M4K1S/coldtrace/hardware/case/coldtrace_case.step

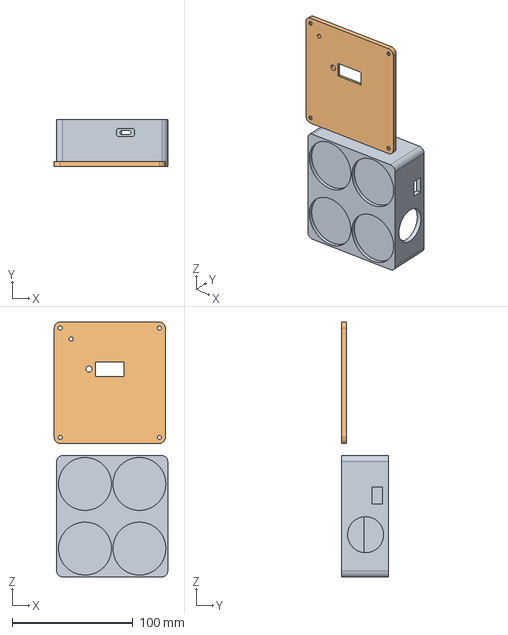
[picture p2: CAD file, 2026-10-11]
hardware/case/coldtrace_case.step
94.0 x 39.0 x 211.0 mm
