M4K1S/coldtrace/hardware/case/stl/case_lid.stl

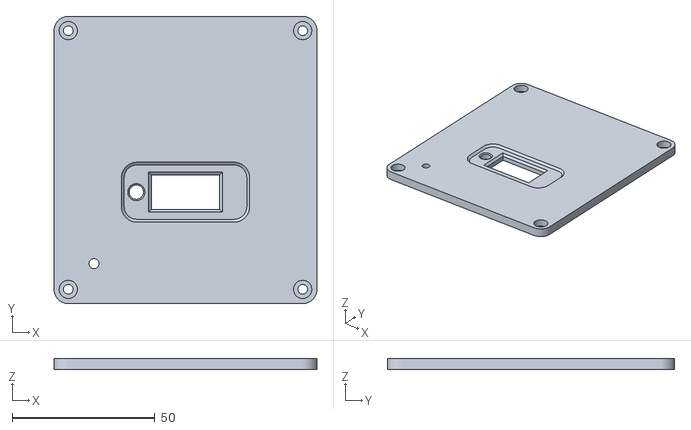
[picture p3: CAD file, 2026-10-11]
hardware/case/stl/case_lid.stl
92.0 x 100.5 x 4.00
