M4K1S/coldtrace/hardware/case/stl/case_base.stl

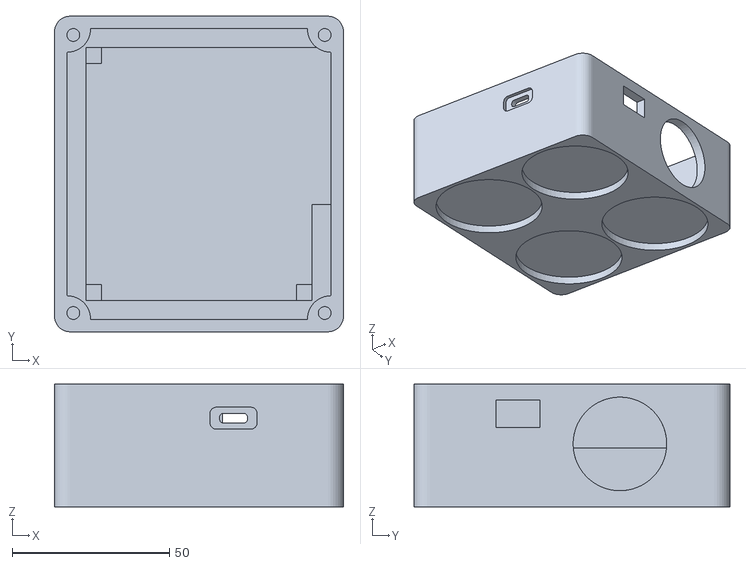
[picture p4: CAD file, 2026-10-11]
hardware/case/stl/case_base.stl
92.0 x 100.5 x 39.0
