M4K1S/coldtrace/(list of files, cad)

Other CAD files:
hardware/case/coldtrace_case.f3d
