M4K1S/coldtrace/hardware/kicad/coldtrace_schematic.pdf

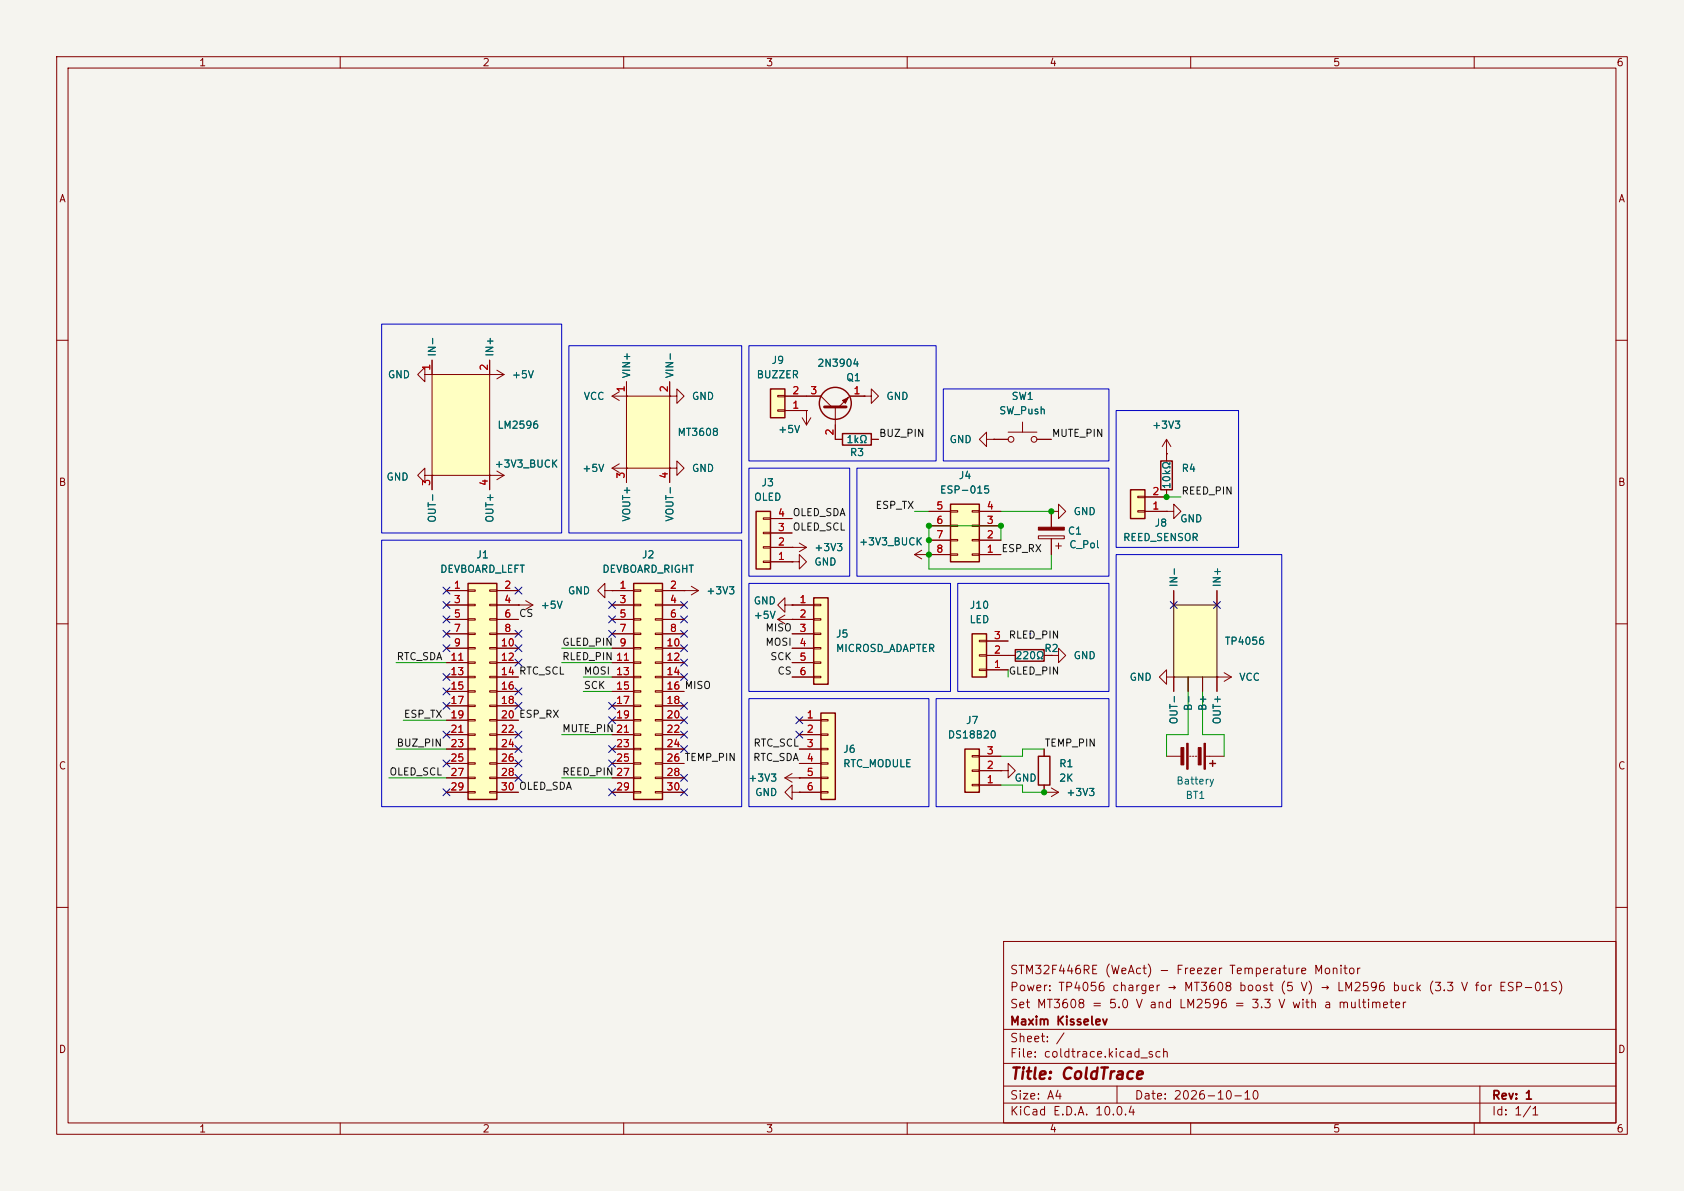
[picture p5: page 1]

STM32F446RE (WeAct) - Freezer Temperature Monitor +3V3_BUCK

Power: TP4056 charger → MT3608 boost (5 V) → LM2596 buck (3.3 V for ESP-01S)
Set MT3608 = 5.0 V and LM2596 = 3.3 V with a multimeter
Maxim Kisselev
Sheet: /
File: coldtrace.kicad_sch
Title: ColdTrace

Size: A4 | Rev: 1
KiCad E.D.A. 10.0.4 | Id: 1/1
