M4K1S/coldtrace/hardware/kicad/coldtrace.kicad_sch

## KiCad design hardware/kicad/coldtrace.kicad_sch (2026-10-11)

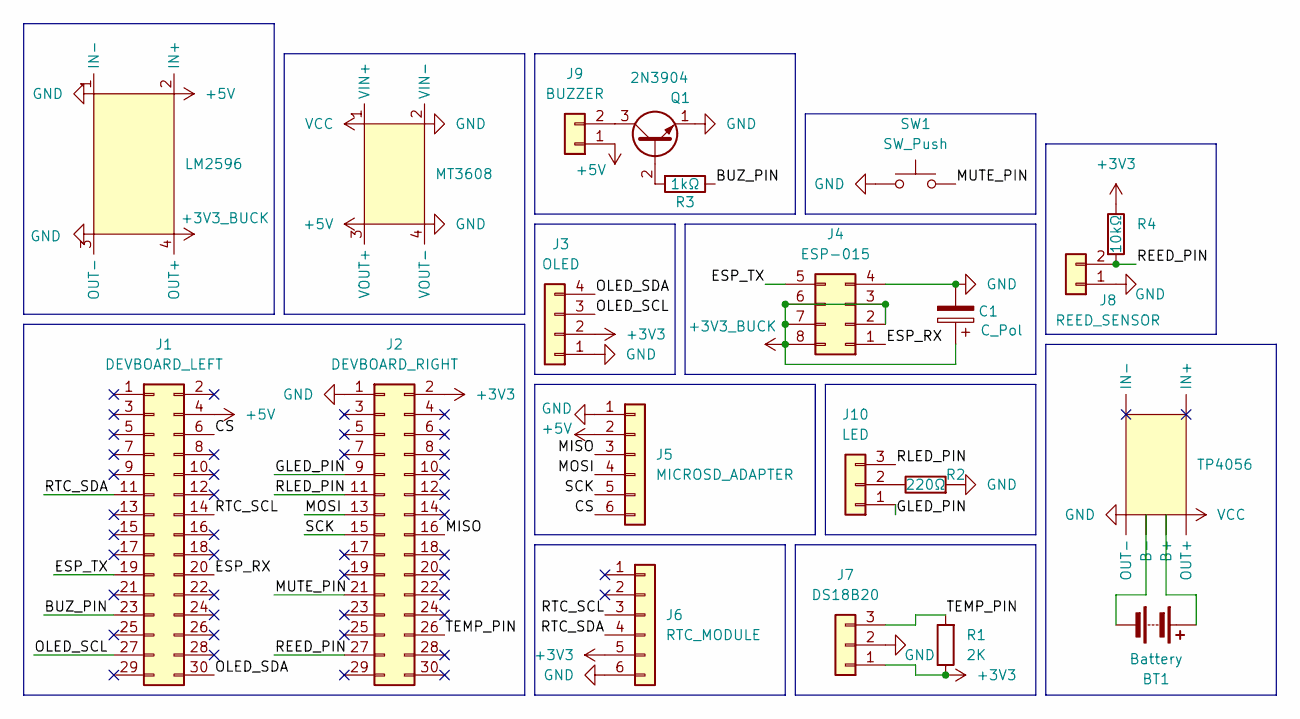
[picture p6: schematic coldtrace.kicad_sch]

Parts:
BT1: Battery
C1: C_Pol
J1: DEVBOARD_LEFT
J2: DEVBOARD_RIGHT
J3: OLED
J4: ESP-015
J5: MICROSD_ADAPTER
J6: RTC_MODULE
J7: DS18B20
J8: REED_SENSOR
J9: BUZZER
J10: LED
LM2596: (no value)
MT3608: (no value)
Q1: 2N3904; TO-92_Inline
R1: 2K
R2: 220Ω
R3: 1kΩ
R4: 10kΩ
SW1: SW_Push
TP4056: (no value)

Connections:
+3V3: J2.2, J3.2, J6.5, J7.1, R1.1, R4.1
+3V3_BUCK: C1.1, J4.2, J4.3, J4.6, J4.7, J4.8, LM2596.4 (OUT+)
+5V: J1.4, J5.2, J9.1, LM2596.2 (IN+), MT3608.3 (VOUT+)
BUZ_PIN: J1.23, R3.1
CS: J1.6, J5.6
ESP_RX: J1.20, J4.1
ESP_TX: J1.19, J4.5
GLED_PIN: J2.9, J10.1
GND: C1.2, J2.1, J3.1, J4.4, J5.1, J6.6, J7.2, J8.1, LM2596.1 (IN-), LM2596.3 (OUT-), MT3608.2 (VIN-), MT3608.4 (VOUT-), Q1.1 (E), R2.2, SW1.1, TP4056.3 (OUT-)
MISO: J2.16, J5.3
MOSI: J2.13, J5.4
MUTE_PIN: J2.21, SW1.2
unnamed: BT1.1 (+), TP4056.5 (B+)
unnamed: BT1.2 (-), TP4056.4 (B-)
unnamed: J9.2, Q1.3 (C)
unnamed: J10.2, R2.1
unnamed: Q1.2 (B), R3.2
OLED_SCL: J1.27, J3.3
OLED_SDA: J1.30, J3.4
REED_PIN: J2.27, J8.2, R4.2
RLED_PIN: J2.11, J10.3
RTC_SCL: J1.14, J6.3
RTC_SDA: J1.11, J6.4
SCK: J2.15, J5.5
TEMP_PIN: J2.26, J7.3, R1.2
VCC: MT3608.1 (VIN+), TP4056.6 (OUT+)
