M4K1S/coldtrace/Core/Inc/secrets.example.h

// Copy this file to secrets.h (gitignored) and fill in your own values.
#ifndef INC_SECRETS_H_
#define INC_SECRETS_H_

#define ESP_WIFI_SSID   "your-wifi-name"        // 2.4 GHz network
#define ESP_WIFI_PASS   "your-wifi-password"
#define ESP_SERVER_HOST "your-app.pythonanywhere.com"

#endif
