M4K1S/coldtrace/(commit log)

2026-08-19 Finished PWM driver
2026-08-19 Added README and tested PWM code through UART
2026-08-19 Added I2C init and notes for peripherals
2026-08-23 Added low level I2C functions, added more TIM options
2026-08-24 Added higher level functions for I2C
2026-08-25 Created and finished DS3231 driver
2026-08-25 Added delay ms, added check RTC time valid, and tested RTC module and Temp sensor together working properly
2026-08-26 Created SPI driver
2026-08-27 Added SD card driver
2026-08-28 Finished logging logic fixed errors in filebase
    [app.h, log.c, log.h]
2026-08-28 Wire up SD card datalogging in App_Init/App_Loop
    App_Init brings up SPI1 + the SD card (slow clock for identification,
    fast clock for block I/O after) and calls log_init(). App_Loop appends
    a (timestamp, temp, door_state) record via log_append_reading() right
    after the existing UART temp print, whenever both the card and the RTC
    read succeed. timestamp is seconds-since-midnight for now (the RTC
    driver doesn't expose a real epoch); door_state is a placeholder 0
    until a door sensor exists.
    Also ignore tools/read_log.py, a local debugging helper for reading
    the raw logger blocks off the card outside the filesystem.
    [app.c]
2026-08-28 Extract peripheral drivers into stm32-baremetal-drivers submodule
    Pulls GPIO/UART/TIM/PWM/I2C/SPI/OneWire/DS18B20/DS3231/SD out of
    Core/Src and Core/Inc into a standalone repo (M4K1S/stm32-baremetal-
    drivers), added here as a submodule at BareMetalDrivers/. Reused
    across projects instead of copy-pasted; this repo stays pinned to a
    specific commit and only updates when explicitly bumped.
    .cproject include paths and source folders updated for both Debug and
    Release configs to pick up BareMetalDrivers/Inc and compile
    BareMetalDrivers/Src. README.md and notes.md updated to point at the
    submodule for driver-level documentation instead of duplicating it
    here.
2026-08-30 Point submodule back at OLED driver commit
2026-09-17 Added ESP8266 WIFI, status LED + reed switch, pins moves, temp display changed to 1dp
2026-10-11 Add Makefile, MIT license, KiCad schematic, case files, and owner guide
